pigatron-industries/xen_matrix/README.md

# Matrix Mixer

A Eurorack module 6x6 matrix mixer
