pigatron-industries/xen_matrix/hardware/xen_matrix_controls_6x6.pdf

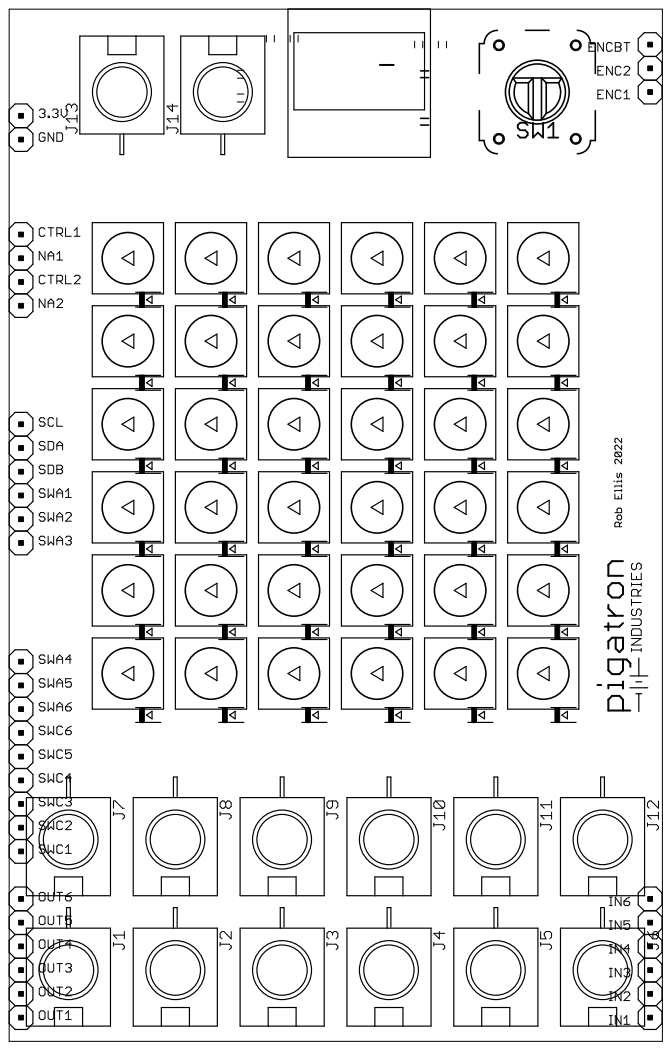
[picture p1: page 1]
