pigatron-industries/xen_matrix/hardware/xen_matrix_panel.pdf

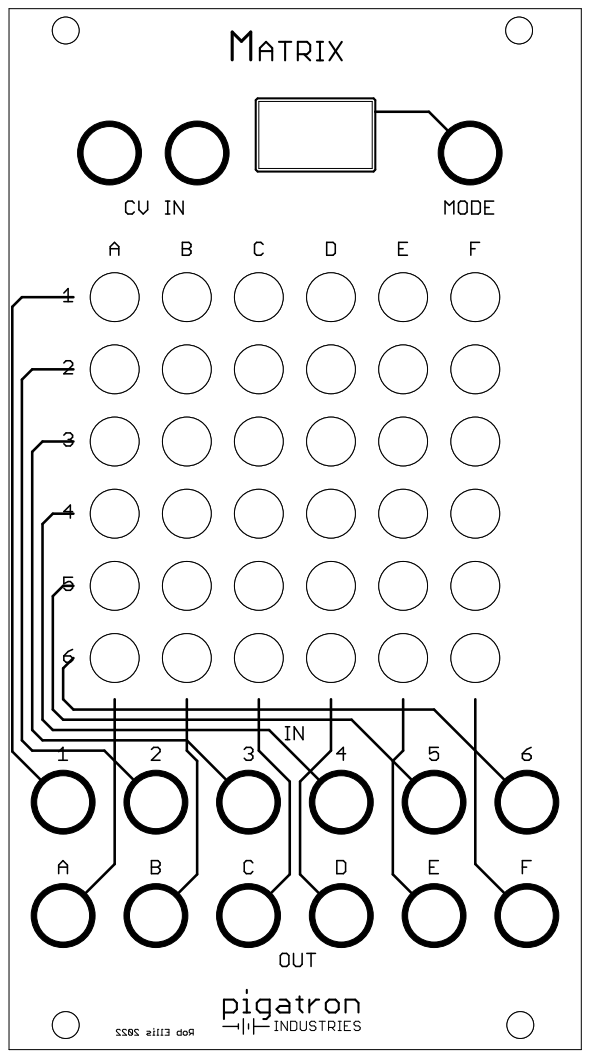
[picture p2: page 1]
