pigatron-industries/xen_matrix/hardware/xen_teensy_motherboard_matrix_mki.pdf

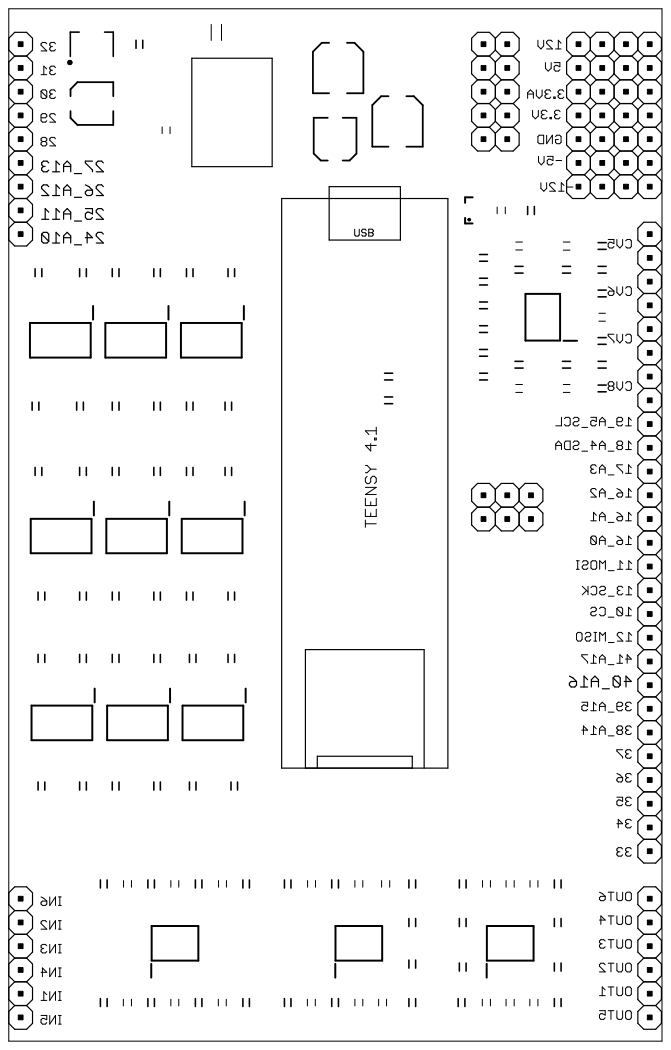
[picture p3: page 1]
