pigatron-industries/xen_matrix/hardware/xen_teensy_motherboard_matrix_mki.brd

## EAGLE design hardware/xen_teensy_motherboard_matrix_mki.brd (2023-10-28)

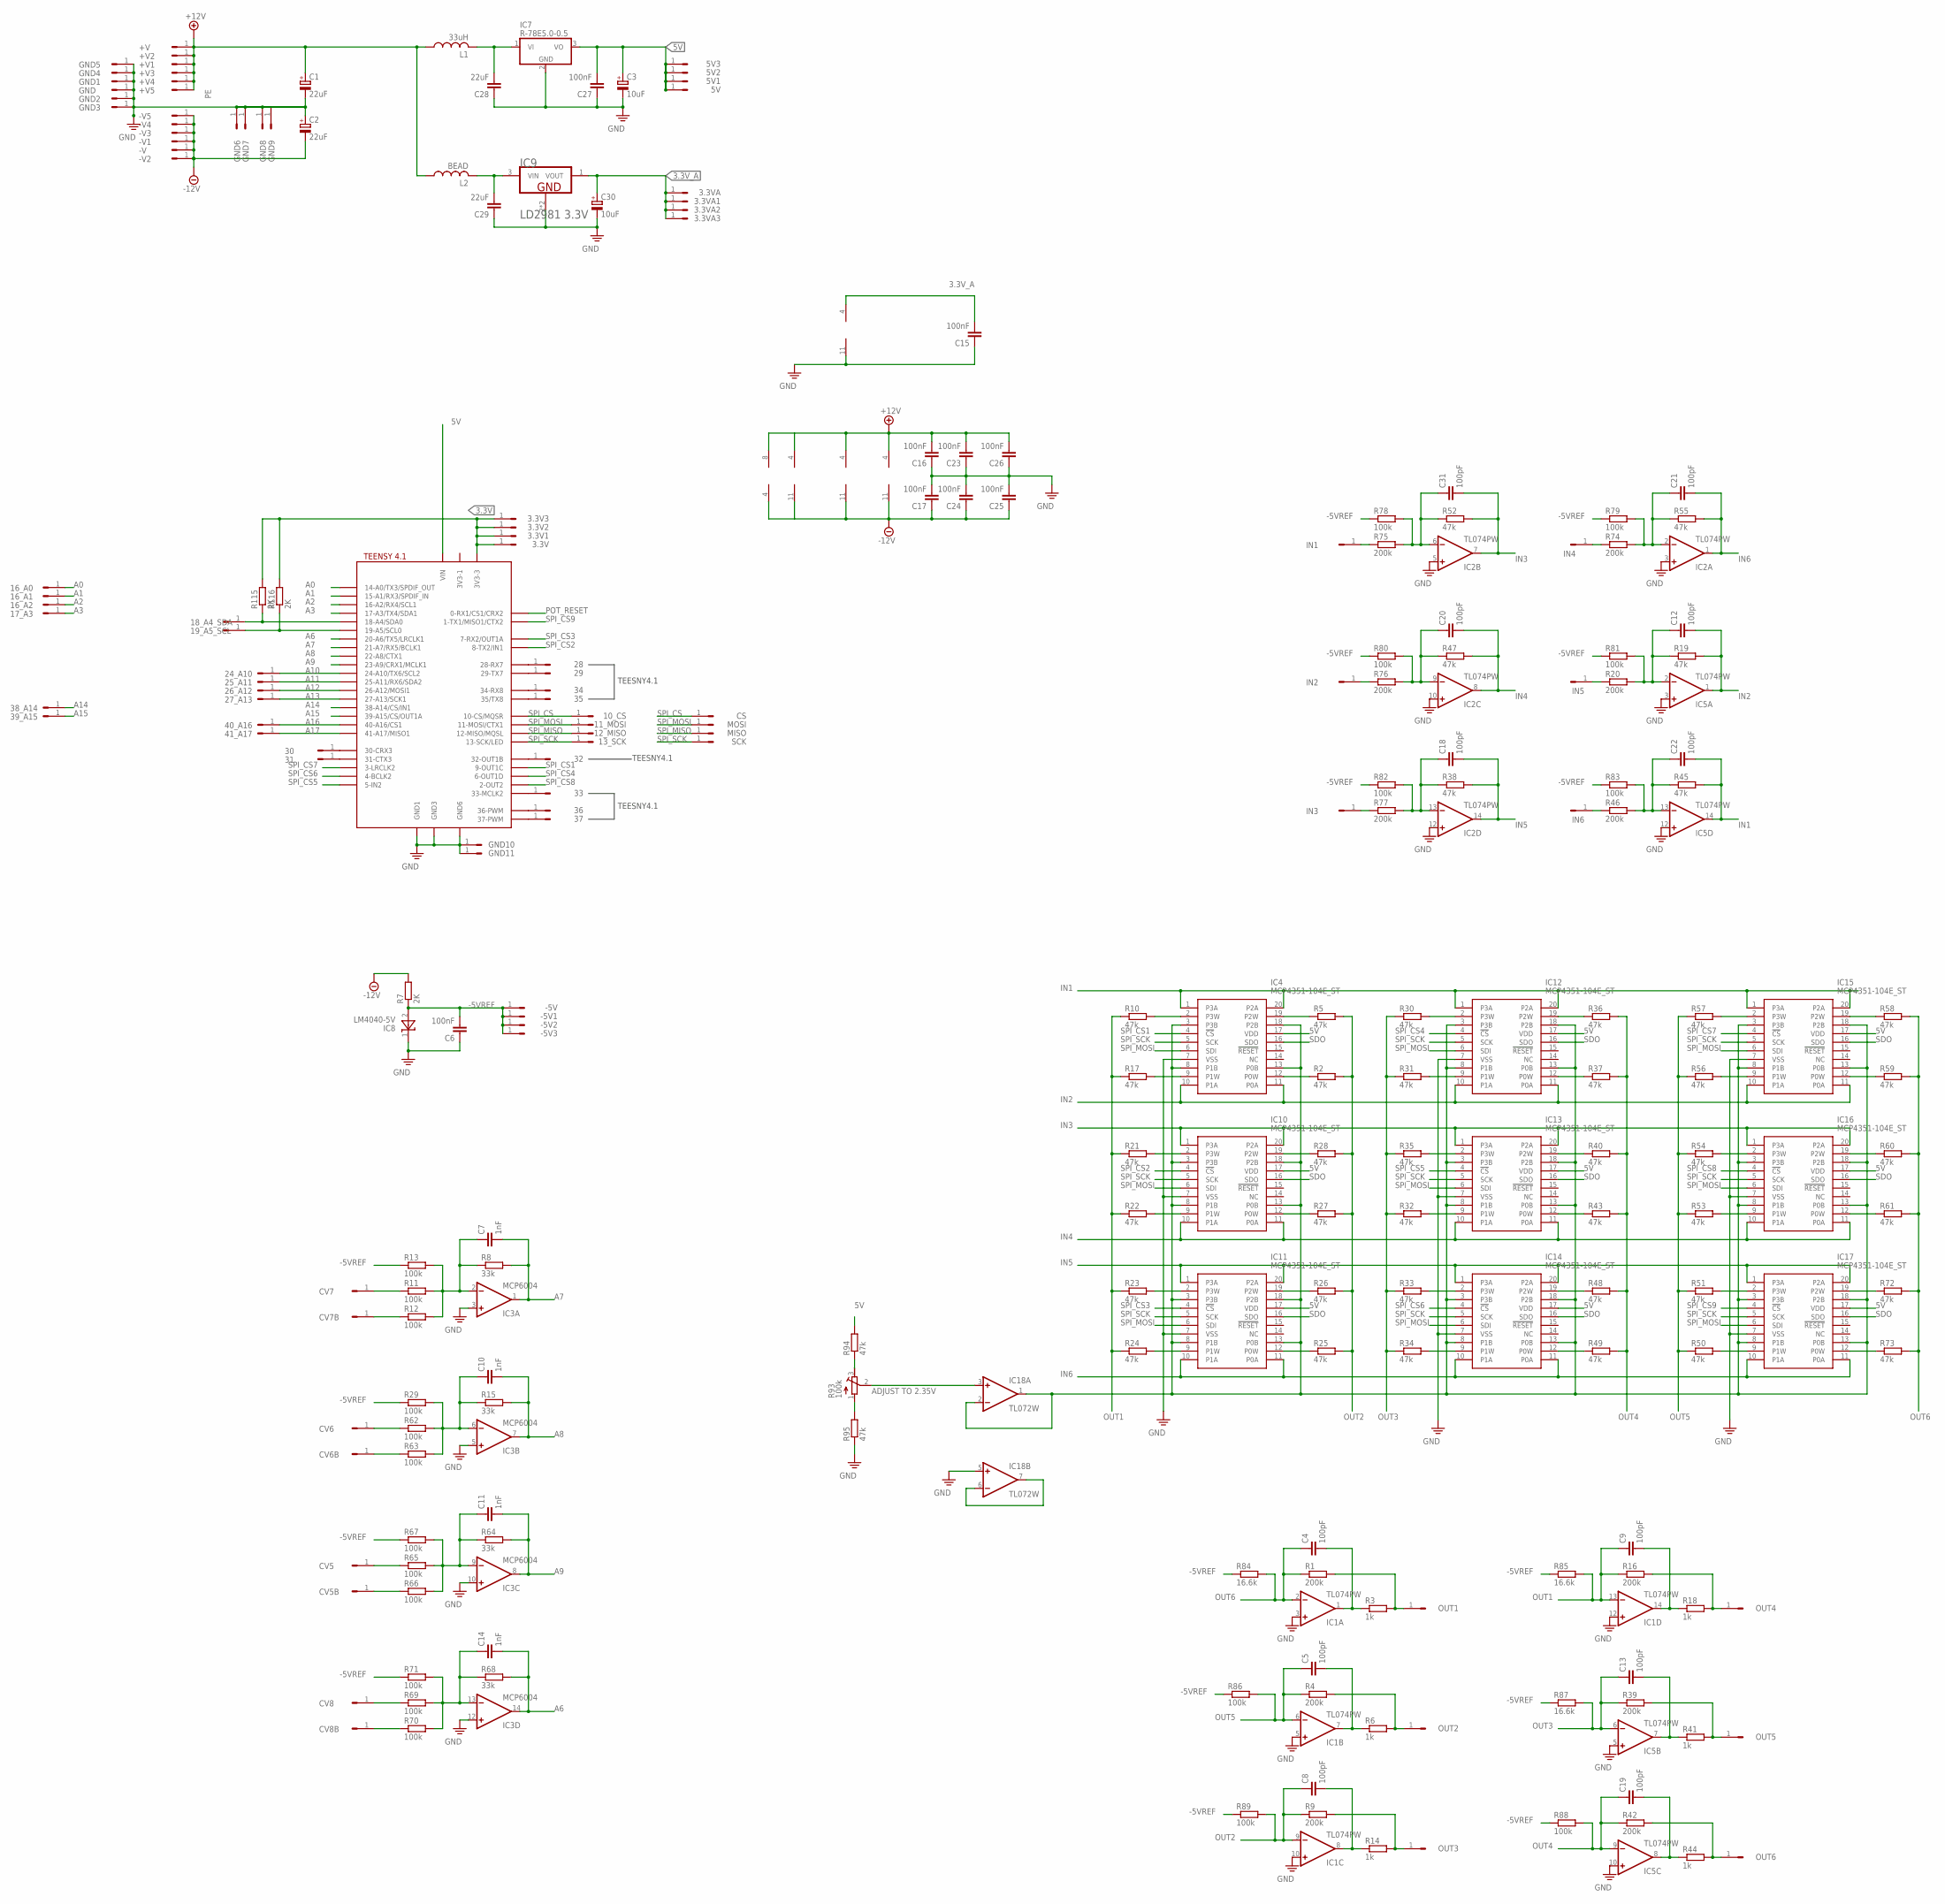
[picture p4: schematic xen_teensy_motherboard_matrix_mki.sch]

Parts:
3.3V, 3.3V1, 3.3V2, 3.3V3, 3.3VA, 3.3VA1, 3.3VA2, 3.3VA3, 5V, 5V1, 5V2, 5V3, 10_CS, 11_MOSI, 12_MISO, 13_SCK, 16_A0, 16_A1, 16_A2, 17_A3, 18_A4_SDA, 19_A5_SCL, 24_A10, 25_A11, 26_A12, 27_A13, 28, 29, 30, 31, 32, 33, 34, 35, 36, 37, 38_A14, 39_A15, 40_A16, 41_A17: HEADER/MALE/01
+V, +V1, +V2, +V3, +V4, +V5: HEADER/MALE/01
-5V, -5V1, -5V2, -5V3: HEADER/MALE/01
-V, -V1, -V2, -V3, -V4, -V5: HEADER/MALE/01
C1, C2: 22uF; SV-C
C3, C30: 10uF; SV-B
C4, C5, C8, C9, C12, C13, C18, C19, C20, C21, C22, C31: 100pF; C0603
C6, C15, C16, C17, C23, C24, C25, C26, C27: 100nF; C0603
C7, C10, C11, C14: 1nF; C0603
C28, C29: 22uF; C0805
CS: HEADER/MALE/01
CV5, CV5B, CV6, CV6B, CV7, CV7B, CV8, CV8B: HEADER/MALE/01
GND, GND1, GND2, GND3, GND4, GND5, GND6, GND7, GND8, GND9, GND10, GND11: HEADER/MALE/01
IC1, IC2, IC5: TL074PW; TSSOP14
IC3: MCP6004; TSSOP14
IC4, IC10, IC11, IC12, IC13, IC14, IC15, IC16, IC17: MCP4351-104E_ST; SOP65P640X120-20N
IC6: TEENSY41-OUTER; TENNSY41-OUTER
IC7: R-78E5.0-0.5; WE78
IC8: LM4040-5V; SOT-23
IC9: LD2981 3.3V; LD2981-SOT89
IC18: TL072W; TSSOP08
IN1, IN2, IN3, IN4, IN5, IN6: HEADER/MALE/01
L1: 33uH; L2012C
L2: BEAD; R0603
MISO: HEADER/MALE/01
MOSI: HEADER/MALE/01
OUT1, OUT2, OUT3, OUT4, OUT5, OUT6: HEADER/MALE/01
R1, R4, R9, R16, R20, R39, R42, R46, R74, R75, R76, R77: 200k; R0603
R2, R5, R10, R17, R19, R21, R22, R23, R24, R25, R26, R27, R28, R30, R31, R32, R33, R34, R35, R36, R37, R38, R40, R43, R45, R47, R48, R49, R50, R51, R52, R53, R54, R55, R56, R57, R58, R59, R60, R61, R72, R73, R94, R95: 47k; R0603
R3, R6, R14, R18, R41, R44: 1k; R0603
R7, R115, R116: 2K; R0603
R8, R15, R64, R68: 33k; R0603
R11, R12, R13, R29, R62, R63, R65, R66, R67, R69, R70, R71, R78, R79, R80, R81, R82, R83, R86, R88, R89: 100k; R0603
R84, R85, R87: 16.6k; R0603
R93: 100k; TRIMMER/64B
SCK: HEADER/MALE/01

Connections:
3.3V: 3.3V.1, 3.3V1.1, 3.3V2.1, 3.3V3.1, IC6.3V3-3, R115.2, R116.2
3.3V_A: 3.3VA.1, 3.3VA1.1, 3.3VA2.1, 3.3VA3.1, C15.2, C30.+, IC3.4 (V+), IC9.1 (VOUT)
5V: 5V.1, 5V1.1, 5V2.1, 5V3.1, C3.+, C27.2, IC4.17 (VDD), IC6.VIN, IC7.3 (VO), IC10.17 (VDD), IC11.17 (VDD), IC12.17 (VDD), IC13.17 (VDD), IC14.17 (VDD), IC15.17 (VDD), IC16.17 (VDD), IC17.17 (VDD), R94.2
+12V: +V.1, +V1.1, +V2.1, +V3.1, +V4.1, +V5.1, C1.+, C16.2, C23.2, C26.2, IC1.4 (V+), IC2.4 (V+), IC5.4 (V+), IC18.8 (V+), L1.1, L2.1
-5VREF: -5V.1, -5V1.1, -5V2.1, -5V3.1, C6.2, IC8.2 (A), R7.1, R13.1, R29.1, R67.1, R71.1, R78.1, R79.1, R80.1, R81.1, R82.1, R83.1, R84.1, R85.1, R86.1, R87.1, R88.1, R89.1
-12V: -V.1, -V1.1, -V2.1, -V3.1, -V4.1, -V5.1, C2.-, C17.1, C24.1, C25.1, IC1.11 (V-), IC2.11 (V-), IC5.11 (V-), IC18.4 (V-), R7.2
A0: 16_A0.1, IC6.14-A0/TX3/SPDIF_OUT
A1: 16_A1.1, IC6.15-A1/RX3/SPDIF_IN
A2: 16_A2.1, IC6.16-A2/RX4/SCL1
A3: 17_A3.1, IC6.17-A3/TX4/SDA1
A5: 19_A5_SCL.1, IC6.19-A5/SCL0, R116.1
A6: C14.2, IC3.14 (OUT), IC6.20-A6/TX5/LRCLK1, R68.2
A7: C7.2, IC3.1 (OUT), IC6.21-A7/RX5/BCLK1, R8.2
A8: C10.2, IC3.7 (OUT), IC6.22-A8/CTX1, R15.2
A9: C11.2, IC3.8 (OUT), IC6.23-A9/CRX1/MCLK1, R64.2
A10: 24_A10.1, IC6.24-A10/TX6/SCL2
A11: 25_A11.1, IC6.25-A11/RX6/SDA2
A12: 26_A12.1, IC6.26-A12/MOSI1
A13: 27_A13.1, IC6.27-A13/SCK1
A14: 38_A14.1, IC6.38-A14/CS/IN1
A15: 39_A15.1, IC6.39-A15/CS/OUT1A
A16: 40_A16.1, IC6.40-A16/CS1
A17: 41_A17.1, IC6.41-A17/MISO1
DAC1: IN6.1, R46.1
DAC2: IN5.1, R20.1
IN1: C22.2, IC4.1 (P3A), IC4.20 (P2A), IC5.14 (OUT), IC12.1 (P3A), IC12.20 (P2A), IC15.1 (P3A), IC15.20 (P2A), R45.2
IN2: C12.2, IC4.10 (P1A), IC4.11 (P0A), IC5.1 (OUT), IC12.10 (P1A), IC12.11 (P0A), IC15.10 (P1A), IC15.11 (P0A), R19.2
IN3: C31.2, IC2.7 (OUT), IC10.1 (P3A), IC10.20 (P2A), IC13.1 (P3A), IC13.20 (P2A), IC16.1 (P3A), IC16.20 (P2A), R52.2
IN4: C20.2, IC2.8 (OUT), IC10.10 (P1A), IC10.11 (P0A), IC13.10 (P1A), IC13.11 (P0A), IC16.10 (P1A), IC16.11 (P0A), R47.2
IN5: C18.2, IC2.14 (OUT), IC11.1 (P3A), IC11.20 (P2A), IC14.1 (P3A), IC14.20 (P2A), IC17.1 (P3A), IC17.20 (P2A), R38.2
IN6: C21.2, IC2.1 (OUT), IC11.10 (P1A), IC11.11 (P0A), IC14.10 (P1A), IC14.11 (P0A), IC17.10 (P1A), IC17.11 (P0A), R55.2
unnamed: IC4.2 (P3W), R10.2
unnamed: C18.1, IC2.13 (-IN), R38.1, R77.2, R82.2
unnamed: C4.2, IC1.1 (OUT), R3.1
unnamed: OUT1.1, R1.2, R3.2
unnamed: IC4.3 (P3B), IC4.8 (P1B), IC4.13 (P0B), IC4.18 (P2B), IC10.3 (P3B), IC10.8 (P1B), IC10.13 (P0B), IC10.18 (P2B), IC11.3 (P3B), IC11.8 (P1B), IC11.13 (P0B), IC11.18 (P2B), IC12.3 (P3B), IC12.8 (P1B), IC12.13 (P0B), IC12.18 (P2B), IC13.3 (P3B), IC13.8 (P1B), IC13.13 (P0B), IC13.18 (P2B), IC14.3 (P3B), IC14.8 (P1B), IC14.13 (P0B), IC14.18 (P2B), IC15.3 (P3B), IC15.8 (P1B), IC15.13 (P0B), IC15.18 (P2B), IC16.3 (P3B), IC16.8 (P1B), IC16.13 (P0B), IC16.18 (P2B), IC17.3 (P3B), IC17.8 (P1B), IC17.13 (P0B), IC17.18 (P2B), IC18.1 (OUT), IC18.2 (-IN)
unnamed: C5.2, IC1.7 (OUT), R6.1
unnamed: OUT2.1, R4.2, R6.2
unnamed: C7.1, IC3.2 (-IN), R8.1, R11.2, R12.2, R13.2
unnamed: IC18.3 (+IN), R93.2 (S)
unnamed: C8.2, IC1.8 (OUT), R14.1
unnamed: OUT3.1, R9.2, R14.2
unnamed: C20.1, IC2.9 (-IN), R47.1, R76.2, R80.2
unnamed: CV7B.1, R12.1
unnamed: CV7.1, R11.1
unnamed: C9.2, IC1.14 (OUT), R18.1
unnamed: C10.1, IC3.6 (-IN), R15.1, R29.2, R62.2, R63.2
unnamed: OUT4.1, R16.2, R18.2
unnamed: CV6.1, R62.1
unnamed: CV6B.1, R63.1
unnamed: C12.1, IC5.2 (-IN), R19.1, R20.2, R81.2
unnamed: IC18.6 (-IN), IC18.7 (OUT)
unnamed: IC4.9 (P1W), R17.2
unnamed: IC10.2 (P3W), R21.2
unnamed: IC10.9 (P1W), R22.2
unnamed: IC11.2 (P3W), R23.2
unnamed: IC11.9 (P1W), R24.2
unnamed: C31.1, IC2.6 (-IN), R52.1, R75.2, R78.2
unnamed: IC11.12 (P0W), R25.1
unnamed: IC11.19 (P2W), R26.1
unnamed: IC10.12 (P0W), R27.1
unnamed: IC10.19 (P2W), R28.1
unnamed: C13.2, IC5.7 (OUT), R41.1
unnamed: IC4.12 (P0W), R2.1
unnamed: IC4.19 (P2W), R5.1
unnamed: IC12.2 (P3W), R30.2
unnamed: IC12.9 (P1W), R31.2
unnamed: IC13.2 (P3W), R35.2
unnamed: IC13.9 (P1W), R32.2
unnamed: IC14.2 (P3W), R33.2
unnamed: IC14.9 (P1W), R34.2
unnamed: OUT5.1, R39.2, R41.2
unnamed: R93.1 (E), R95.2
unnamed: C19.2, IC5.8 (OUT), R44.1
unnamed: 18_A4_SDA.1, IC6.18-A4/SDA0, R115.1
unnamed: IC14.12 (P0W), R49.1
unnamed: OUT6.1, R42.2, R44.2
unnamed: C22.1, IC5.13 (-IN), R45.1, R46.2, R83.2
unnamed: R93.3 (A), R94.1
unnamed: C21.1, IC2.2 (-IN), R55.1, R74.2, R79.2
unnamed: C28.2, IC7.1 (VI), L1.2
unnamed: IC14.19 (P2W), R48.1
unnamed: IC13.12 (P0W), R43.1
unnamed: IC13.19 (P2W), R40.1
unnamed: IC12.12 (P0W), R37.1
unnamed: IC12.19 (P2W), R36.1
unnamed: C14.1, IC3.13 (-IN), R68.1, R69.2, R70.2, R71.2
unnamed: IC15.2 (P3W), R57.2
unnamed: IC15.9 (P1W), R56.2
unnamed: CV8.1, R69.1
unnamed: IC16.2 (P3W), R54.2
unnamed: IC16.9 (P1W), R53.2
unnamed: IC17.2 (P3W), R51.2
unnamed: IC17.9 (P1W), R50.2
unnamed: IC17.12 (P0W), R73.1
unnamed: IC17.19 (P2W), R72.1
unnamed: IC16.12 (P0W), R61.1
unnamed: CV8B.1, R70.1
unnamed: CV5B.1, R66.1
unnamed: CV5.1, R65.1
unnamed: C11.1, IC3.9 (-IN), R64.1, R65.2, R66.2, R67.2
unnamed: C29.2, IC9.3 (VIN), L2.2
unnamed: IC16.19 (P2W), R60.1
unnamed: IC15.12 (P0W), R59.1
unnamed: IC15.19 (P2W), R58.1
unnamed: IN1.1, R75.1
unnamed: IN2.1, R76.1
unnamed: IN3.1, R77.1
unnamed: IN4.1, R74.1
unnamed: 28.1, IC6.28-RX7
unnamed: 29.1, IC6.29-TX7
unnamed: 30.1, IC6.30-CRX3
unnamed: 31.1, IC6.31-CTX3
unnamed: 32.1, IC6.32-OUT1B
unnamed: 34.1, IC6.34-RX8
unnamed: 35.1, IC6.35-TX8 (35/TX8)
unnamed: 33.1, IC6.33-MCLK2
unnamed: 36.1, IC6.36-PWM
unnamed: 37.1, IC6.37-PWM
OUT1: C9.1, IC1.13 (-IN), R10.1, R16.1, R17.1, R21.1, R22.1, R23.1, R24.1, R85.2
OUT2: C8.1, IC1.9 (-IN), R2.2, R5.2, R9.1, R25.2, R26.2, R27.2, R28.2, R89.2
OUT3: C13.1, IC5.6 (-IN), R30.1, R31.1, R32.1, R33.1, R34.1, R35.1, R39.1, R87.2
OUT4: C19.1, IC5.9 (-IN), R36.2, R37.2, R40.2, R42.1, R43.2, R48.2, R49.2, R88.2
OUT5: C5.1, IC1.6 (-IN), R4.1, R50.1, R51.1, R53.1, R54.1, R56.1, R57.1, R86.2
OUT6: C4.1, IC1.2 (-IN), R1.1, R58.2, R59.2, R60.2, R61.2, R72.2, R73.2, R84.2
PE: C1.-, C2.+, C3.-, C6.1, C15.1, C16.1, C17.2, C23.1, C24.2, C25.2, C26.1, C27.1, C28.1, C29.1, C30.-, GND.1, GND1.1, GND2.1, GND3.1, GND4.1, GND5.1, GND6.1, GND7.1, GND8.1, GND9.1, GND10.1, GND11.1, IC1.3 (+IN), IC1.5 (+IN), IC1.10 (+IN), IC1.12 (+IN), IC2.3 (+IN), IC2.5 (+IN), IC2.10 (+IN), IC2.12 (+IN), IC3.3 (+IN), IC3.5 (+IN), IC3.10 (+IN), IC3.11 (V-), IC3.12 (+IN), IC4.7 (VSS), IC5.3 (+IN), IC5.5 (+IN), IC5.10 (+IN), IC5.12 (+IN), IC6.GND1, IC6.GND3, IC6.GND6, IC7.2 (GND), IC8.1 (C), IC9.2 (GND), IC9.2-2 (GND), IC10.7 (VSS), IC11.7 (VSS), IC12.7 (VSS), IC13.7 (VSS), IC14.7 (VSS), IC15.7 (VSS), IC16.7 (VSS), IC17.7 (VSS), IC18.5 (+IN), R95.1
POT_RESET: IC6.0-RX1/CS1/CRX2
SDO: IC4.16 (SDO), IC10.16 (SDO), IC11.16 (SDO), IC12.16 (SDO), IC13.16 (SDO), IC14.16 (SDO), IC15.16 (SDO), IC16.16 (SDO), IC17.16 (SDO)
SPI_CS: 10_CS.1, CS.1, IC6.10-CS\MQSR (10-CS/MQSR)
SPI_CS1: IC4.4 (!CS), IC6.9-OUT1C
SPI_CS2: IC6.8-TX2/IN1, IC10.4 (!CS)
SPI_CS3: IC6.7-RX2/OUT1A, IC11.4 (!CS)
SPI_CS4: IC6.6-OUT1D, IC12.4 (!CS)
SPI_CS5: IC6.5-IN2, IC13.4 (!CS)
SPI_CS6: IC6.4-BCLK2, IC14.4 (!CS)
SPI_CS7: IC6.3-LRCLK2, IC15.4 (!CS)
SPI_CS8: IC6.2-OUT2, IC16.4 (!CS)
SPI_CS9: IC6.1-TX1/MISO1/CTX2, IC17.4 (!CS)
SPI_MISO: 12_MISO.1, IC6.12-MISO/MQSL, MISO.1
SPI_MOSI: 11_MOSI.1, IC4.6 (SDI), IC6.11-MOSI/CTX1, IC10.6 (SDI), IC11.6 (SDI), IC12.6 (SDI), IC13.6 (SDI), IC14.6 (SDI), IC15.6 (SDI), IC16.6 (SDI), IC17.6 (SDI), MOSI.1
SPI_SCK: 13_SCK.1, IC4.5 (SCK), IC6.13-SCK/LED, IC10.5 (SCK), IC11.5 (SCK), IC12.5 (SCK), IC13.5 (SCK), IC14.5 (SCK), IC15.5 (SCK), IC16.5 (SCK), IC17.5 (SCK), SCK.1

Notes on the sheet:
TEESNY4.1
ADJUST TO 2.35V

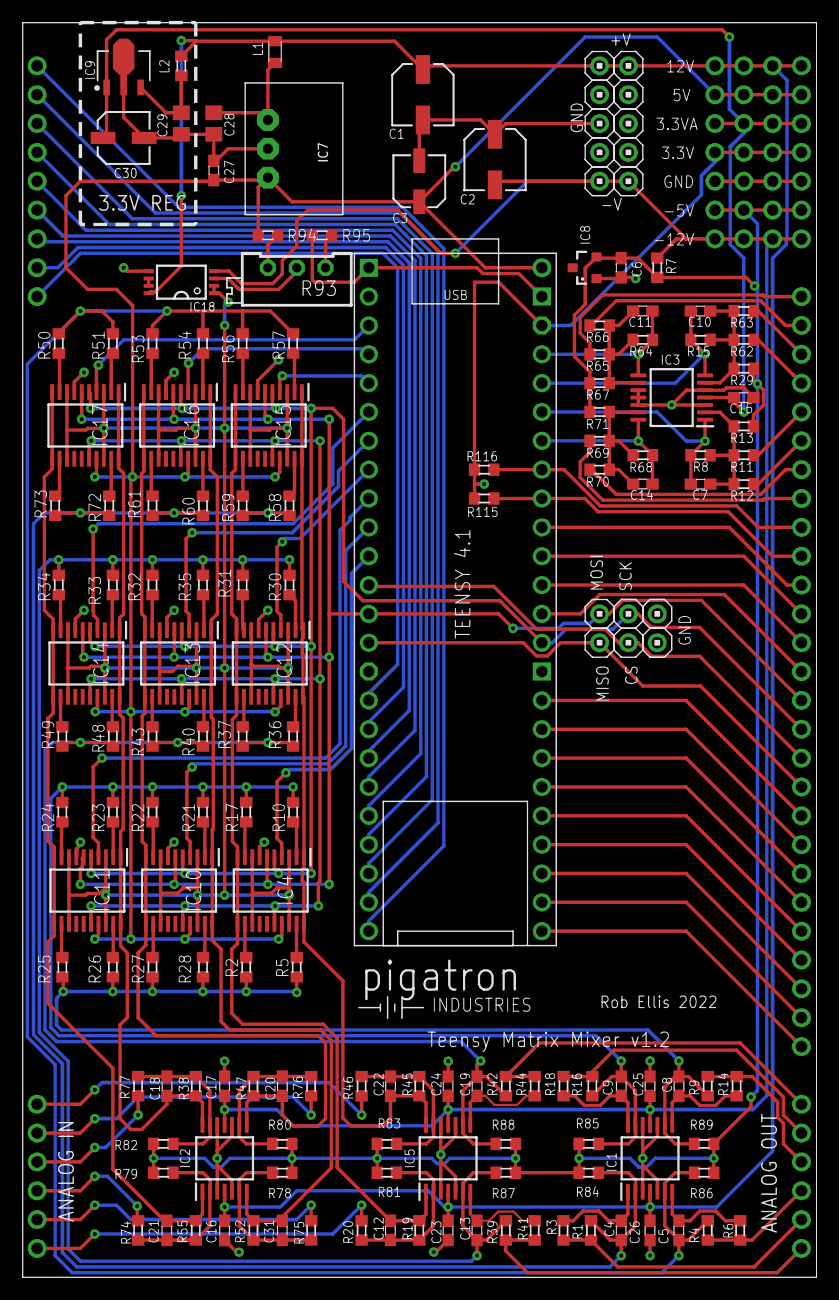
[picture p5: board xen_teensy_motherboard_matrix_mki.brd from above]

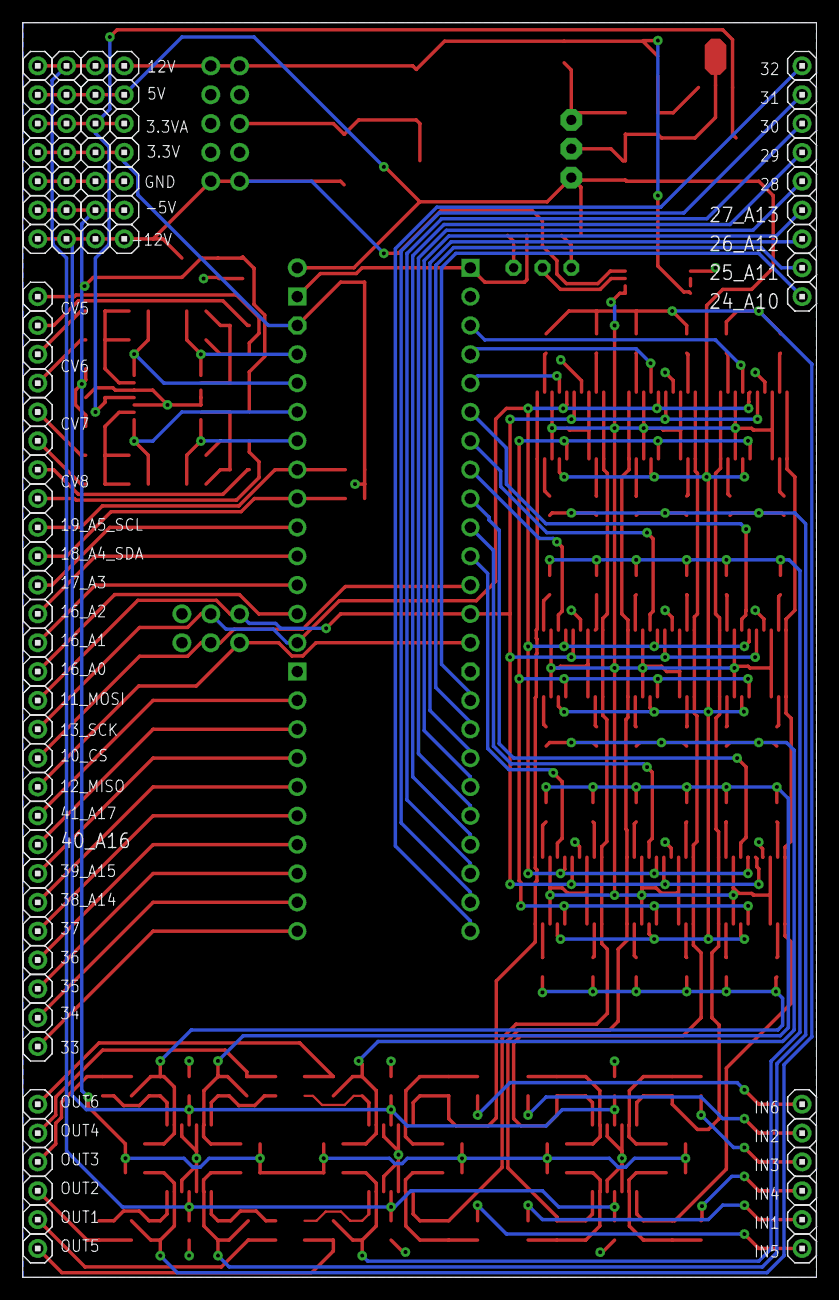
[picture p6: board xen_teensy_motherboard_matrix_mki.brd from below]

Board: 2 copper layers, 69.9 x 110.5 mm, 238 parts (76 on the bottom side), 140 nets.

Other parts of the board:
U$1: PIGATRON-LOGO
