pigatron-industries/xen_matrix/hardware/xen_matrix_controls_6x6.brd

## EAGLE design hardware/xen_matrix_controls_6x6.brd (2023-02-06)

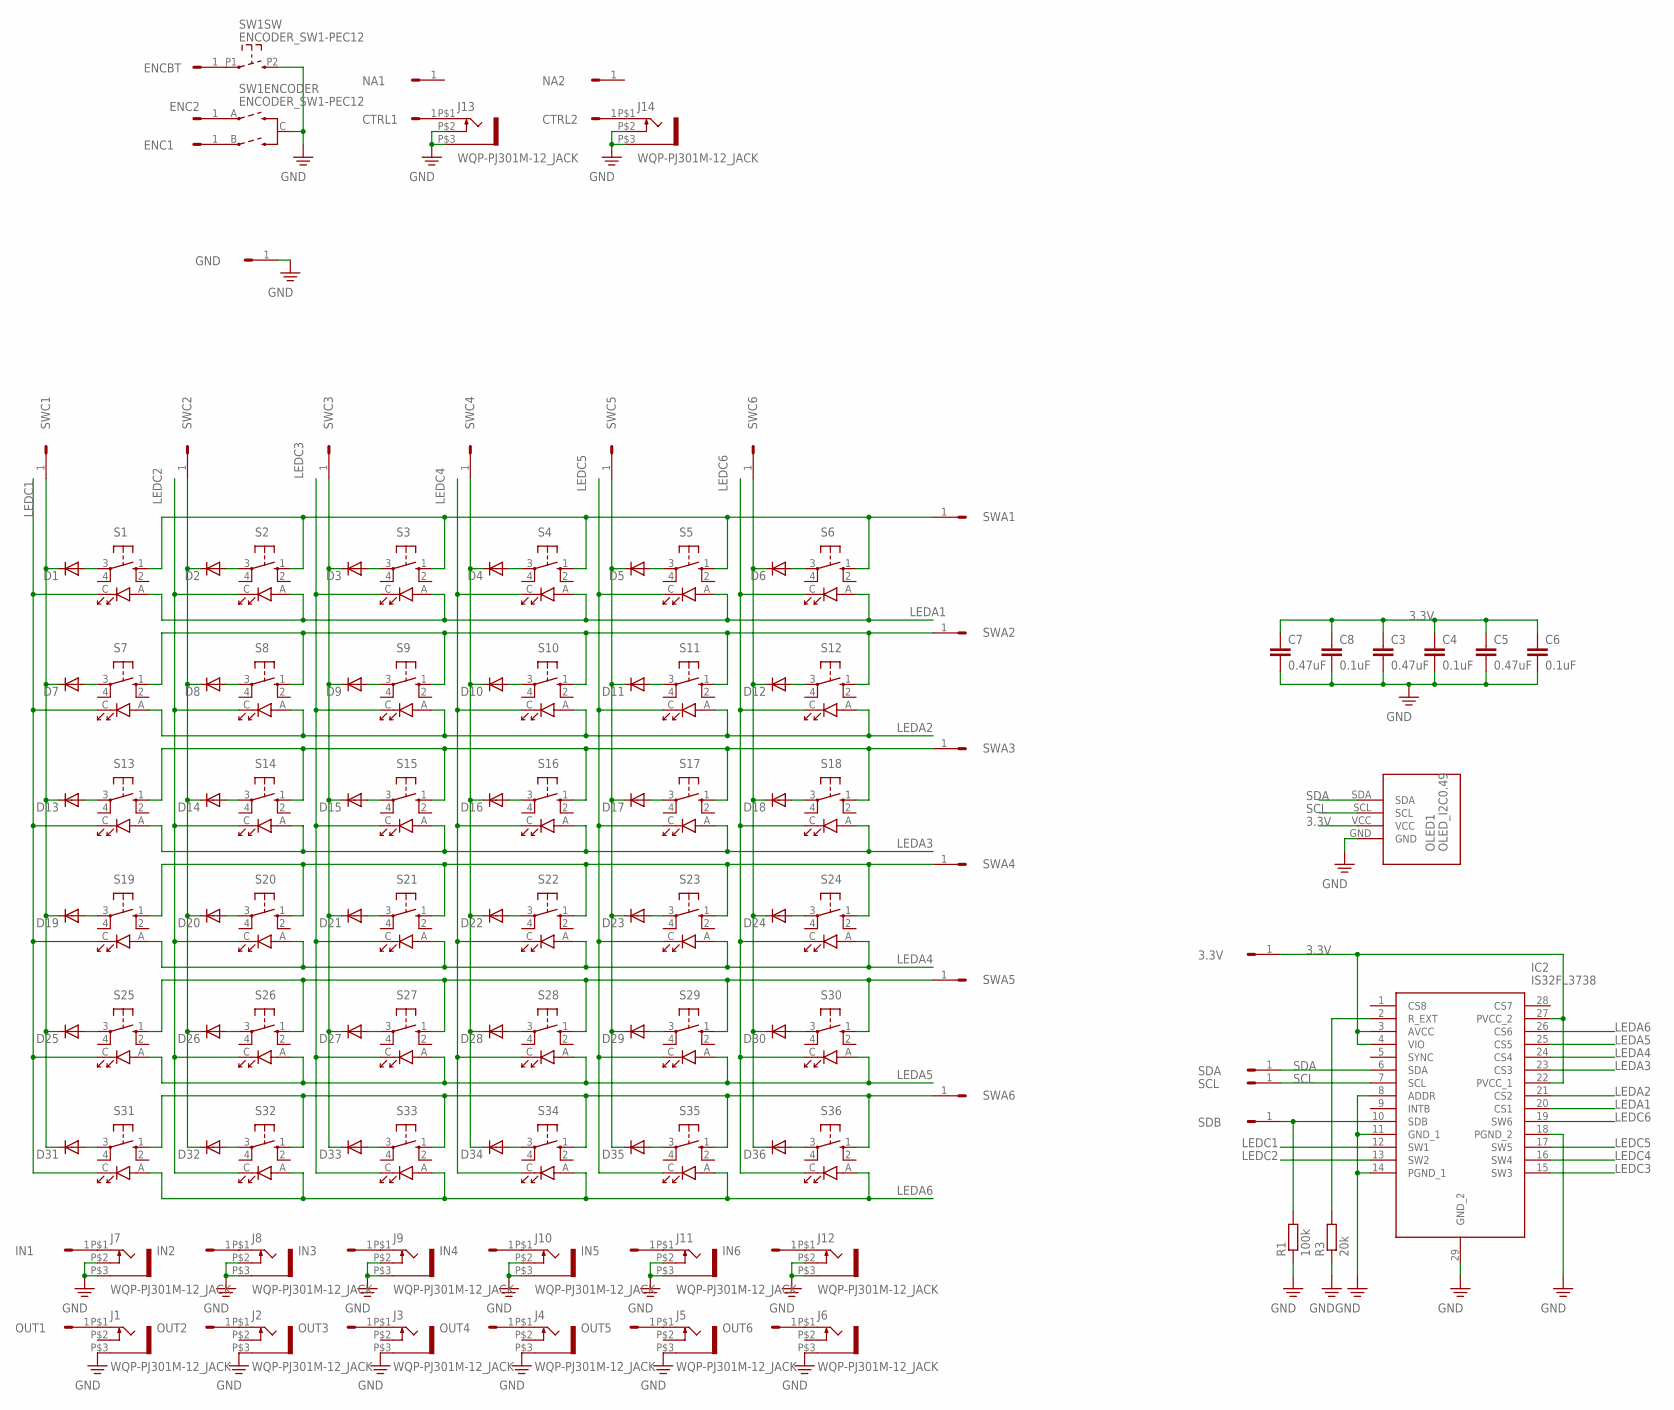
[picture p7: schematic xen_matrix_controls_6x6.sch]

Parts:
3.3V: HEADER/MALE/01
C3, C5, C7: 0.47uF; C0603
C4, C6, C8: 0.1uF; C0603
CTRL1, CTRL2: HEADER/MALE/01
D1, D2, D3, D4, D5, D6, D7, D8, D9, D10, D11, D12, D13, D14, D15, D16, D17, D18, D19, D20, D21, D22, D23, D24, D25, D26, D27, D28, D29, D30, D31, D32, D33, D34, D35, D36: 1N4148SOD-123; SOD-123
ENC1, ENC2: HEADER/MALE/01
ENCBT: HEADER/MALE/01
GND: HEADER/MALE/01
IC2: IS32FL3738; TSSOP29
IN1, IN2, IN3, IN4, IN5, IN6: HEADER/MALE/01
J1, J2, J3, J4, J5, J6, J7, J8, J9, J10, J11, J12, J13, J14: WQP-PJ301M-12_JACK
NA1, NA2: HEADER/MALE/01
OLED1: OLED_I2C0.49; OLEDM0.49
OUT1, OUT2, OUT3, OUT4, OUT5, OUT6: HEADER/MALE/01
R1: 100k; R0603
R3: 20k; R0603
S1, S2, S3, S4, S5, S6, S7, S8, S9, S10, S11, S12, S13, S14, S15, S16, S17, S18, S19, S20, S21, S22, S23, S24, S25, S26, S27, S28, S29, S30, S31, S32, S33, S34, S35, S36: SW-LEDTHONK; SW-PUSH-TACT-LED-THONK
SCL: HEADER/MALE/01
SDA: HEADER/MALE/01
SDB: HEADER/MALE/01
SW1: ENCODER_SW1-PEC12; PEC12_INCREMENTAL_ENCODER
SWA1, SWA2, SWA3, SWA4, SWA5, SWA6: HEADER/MALE/01
SWC1, SWC2, SWC3, SWC4, SWC5, SWC6: HEADER/MALE/01

Connections:
3.3V: 3.3V.1, C3.1, C4.1, C5.1, C6.1, C7.1, C8.1, IC2.3 (AVCC), IC2.4 (VIO), IC2.22 (PVCC_1), IC2.27 (PVCC_2), OLED1.VCC
LEDA1: IC2.20 (CS1), S1.A, S2.A, S3.A, S4.A, S5.A, S6.A
LEDA2: IC2.21 (CS2), S7.A, S8.A, S9.A, S10.A, S11.A, S12.A
LEDA3: IC2.23 (CS3), S13.A, S14.A, S15.A, S16.A, S17.A, S18.A
LEDA4: IC2.24 (CS4), S19.A, S20.A, S21.A, S22.A, S23.A, S24.A
LEDA5: IC2.25 (CS5), S25.A, S26.A, S27.A, S28.A, S29.A, S30.A
LEDA6: IC2.26 (CS6), S31.A, S32.A, S33.A, S34.A, S35.A, S36.A
LEDC1: IC2.12 (SW1), S1.C, S7.C, S13.C, S19.C, S25.C, S31.C
LEDC2: IC2.13 (SW2), S2.C, S8.C, S14.C, S20.C, S26.C, S32.C
LEDC3: IC2.15 (SW3), S3.C, S9.C, S15.C, S21.C, S27.C, S33.C
LEDC4: IC2.16 (SW4), S4.C, S10.C, S16.C, S22.C, S28.C, S34.C
LEDC5: IC2.17 (SW5), S5.C, S11.C, S17.C, S23.C, S29.C, S35.C
LEDC6: IC2.19 (SW6), S6.C, S12.C, S18.C, S24.C, S30.C, S36.C
unnamed: IC2.10 (SDB), R1.2, SDB.1
unnamed: IC2.2 (R_EXT), R3.2
unnamed: S25.1 (S), S26.1 (S), S27.1 (S), S28.1 (S), S29.1 (S), S30.1 (S), SWA5.1
unnamed: S1.1 (S), S2.1 (S), S3.1 (S), S4.1 (S), S5.1 (S), S6.1 (S), SWA1.1
unnamed: D1.A, S1.3
unnamed: S7.1 (S), S8.1 (S), S9.1 (S), S10.1 (S), S11.1 (S), S12.1 (S), SWA2.1
unnamed: D4.A, S4.3
unnamed: D5.A, S5.3
unnamed: S13.1 (S), S14.1 (S), S15.1 (S), S16.1 (S), S17.1 (S), S18.1 (S), SWA3.1
unnamed: S19.1 (S), S20.1 (S), S21.1 (S), S22.1 (S), S23.1 (S), S24.1 (S), SWA4.1
unnamed: D6.A, S6.3
unnamed: S31.1 (S), S32.1 (S), S33.1 (S), S34.1 (S), S35.1 (S), S36.1 (S), SWA6.1
unnamed: D7.A, S7.3
unnamed: D8.A, S8.3
unnamed: D9.A, S9.3
unnamed: D10.A, S10.3
unnamed: D11.A, S11.3
unnamed: D12.A, S12.3
unnamed: D13.A, S13.3
unnamed: D14.A, S14.3
unnamed: D15.A, S15.3
unnamed: D16.A, S16.3
unnamed: D17.A, S17.3
unnamed: D18.A, S18.3
unnamed: D19.A, S19.3
unnamed: D20.A, S20.3
unnamed: D21.A, S21.3
unnamed: D22.A, S22.3
unnamed: D23.A, S23.3
unnamed: D24.A, S24.3
unnamed: D25.A, S25.3
unnamed: D26.A, S26.3
unnamed: D27.A, S27.3
unnamed: D28.A, S28.3
unnamed: D29.A, S29.3
unnamed: D30.A, S30.3
unnamed: D31.A, S31.3
unnamed: D32.A, S32.3
unnamed: D33.A, S33.3
unnamed: D34.A, S34.3
unnamed: D35.A, S35.3
unnamed: D36.A, S36.3
unnamed: D2.A, S2.3
unnamed: D3.A, S3.3
unnamed: D1.C, D7.C, D13.C, D19.C, D25.C, D31.C, SWC1.1
unnamed: D2.C, D8.C, D14.C, D20.C, D26.C, D32.C, SWC2.1
unnamed: D3.C, D9.C, D15.C, D21.C, D27.C, D33.C, SWC3.1
unnamed: D4.C, D10.C, D16.C, D22.C, D28.C, D34.C, SWC4.1
unnamed: D5.C, D11.C, D17.C, D23.C, D29.C, D35.C, SWC5.1
unnamed: D6.C, D12.C, D18.C, D24.C, D30.C, D36.C, SWC6.1
unnamed: J2.P$1 (2), OUT2.1
unnamed: J1.P$1 (2), OUT1.1
unnamed: J3.P$1 (2), OUT3.1
unnamed: J4.P$1 (2), OUT4.1
unnamed: J5.P$1 (2), OUT5.1
unnamed: J6.P$1 (2), OUT6.1
unnamed: ENC2.1, SW1.A
unnamed: IN1.1, J7.P$1 (2)
unnamed: IN2.1, J8.P$1 (2)
unnamed: IN3.1, J9.P$1 (2)
unnamed: IN4.1, J10.P$1 (2)
unnamed: IN5.1, J11.P$1 (2)
unnamed: IN6.1, J12.P$1 (2)
unnamed: CTRL1.1, J13.P$1 (2)
unnamed: CTRL2.1, J14.P$1 (2)
unnamed: ENC1.1, SW1.B
unnamed: ENCBT.1, SW1.P1 (1)
PE: C3.2, C4.2, C5.2, C6.2, C7.2, C8.2, GND.1, IC2.8 (ADDR), IC2.11 (GND_1), IC2.14 (PGND_1), IC2.18 (PGND_2), IC2.29 (GND_2), J1.P$3 (1), J2.P$3 (1), J3.P$3 (1), J4.P$3 (1), J5.P$3 (1), J6.P$3 (1), J7.P$2 (3), J7.P$3 (1), J8.P$2 (3), J8.P$3 (1), J9.P$2 (3), J9.P$3 (1), J10.P$2 (3), J10.P$3 (1), J11.P$2 (3), J11.P$3 (1), J12.P$2 (3), J12.P$3 (1), J13.P$2 (3), J13.P$3 (1), J14.P$2 (3), J14.P$3 (1), OLED1.GND, R1.1, R3.1, SW1.C, SW1.P2 (2)
SCL: IC2.7 (SCL), OLED1.SCL, SCL.1
SDA: IC2.6 (SDA), OLED1.SDA, SDA.1

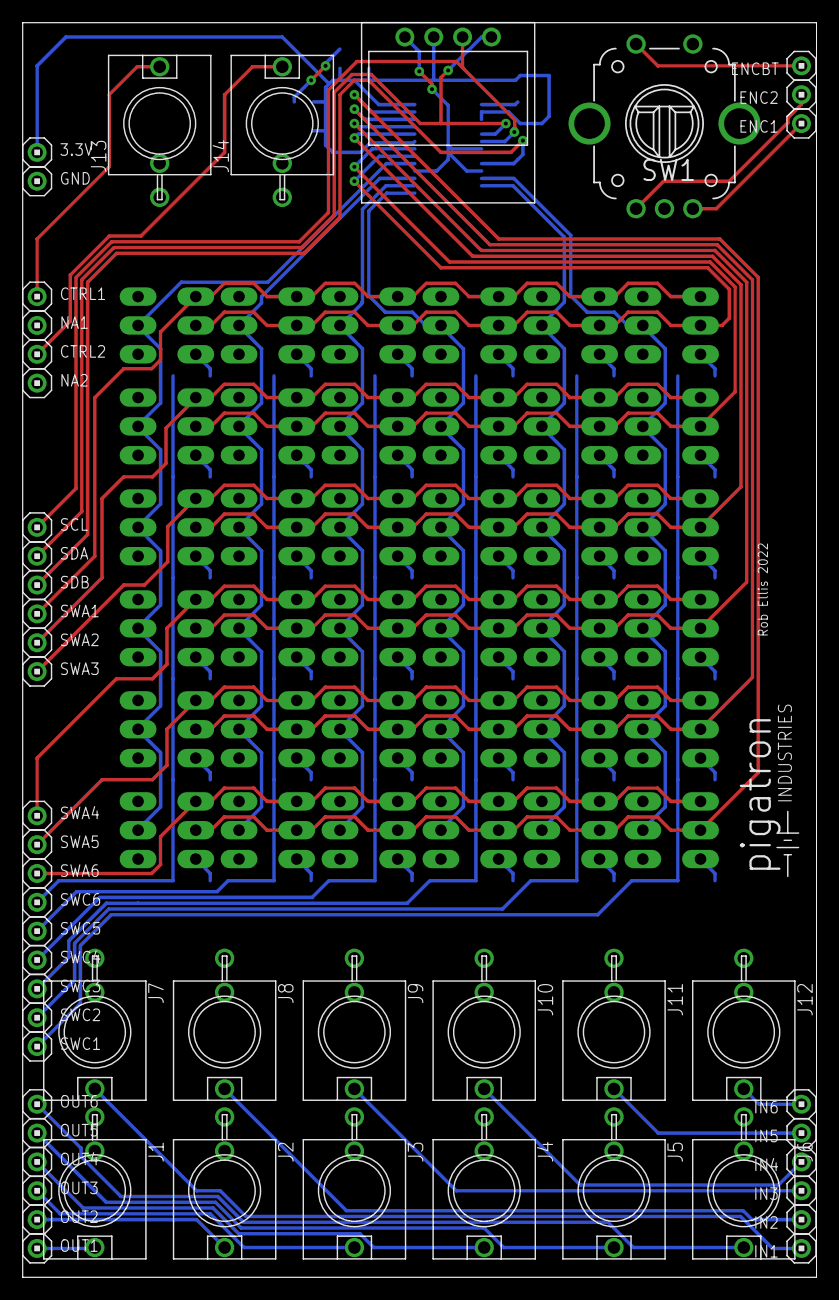
[picture p8: board xen_matrix_controls_6x6.brd from above]

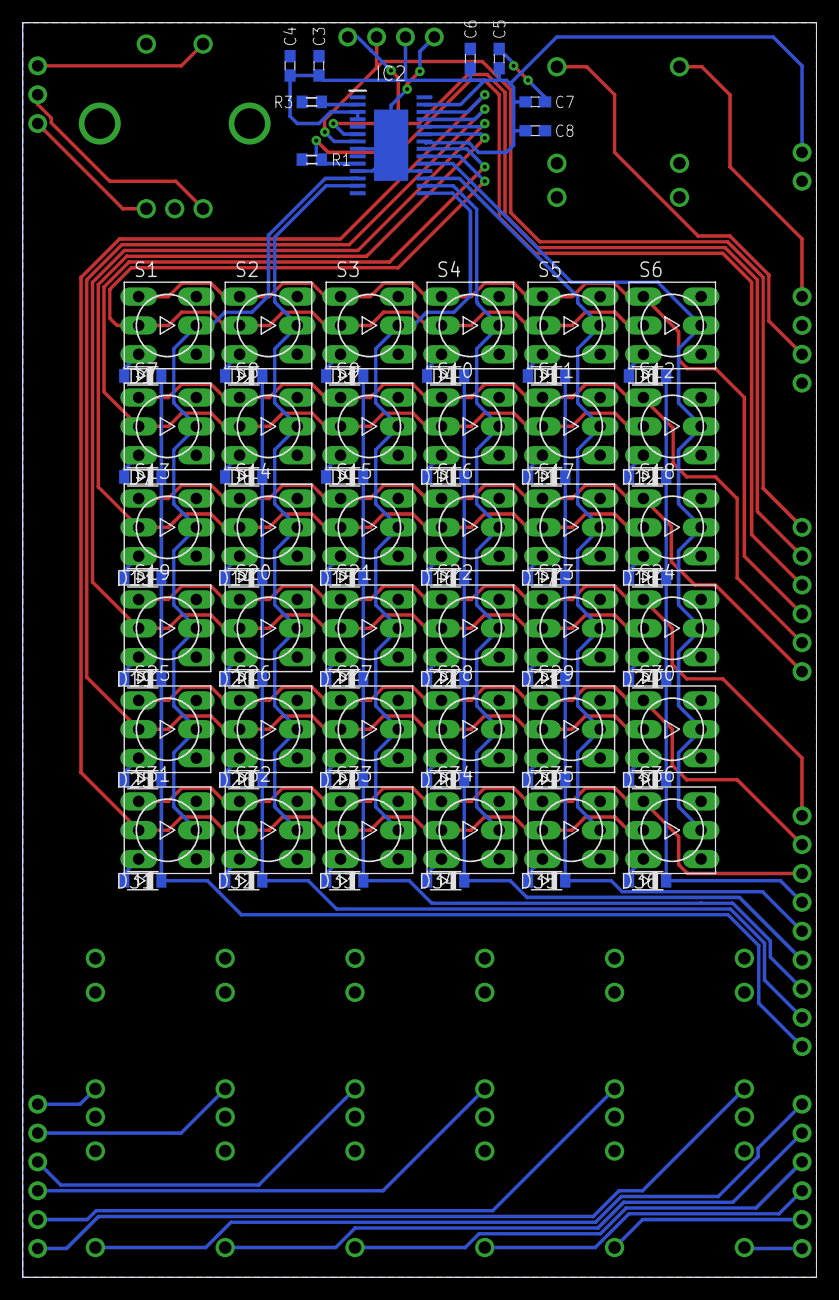
[picture p9: board xen_matrix_controls_6x6.brd from below]

Board: 2 copper layers, 69.9 x 110.5 mm, 134 parts (81 on the bottom side), 83 nets.

Other parts of the board:
U$1: PIGATRON-LOGO
