pigatron-industries/xen_matrix/src/hwconfig.h

// Teensy Pins
#define ENCODER_BTN_PIN 32
#define ENCODER_PIN1 30
#define ENCODER_PIN2 31
#define CV1_PIN A9
#define CV2_PIN A8

#define SDB_PIN 17
#define SCL_PIN 19
#define SDA_PIN 18
#define I2C_SPEED 1000000

#define POT1_CS 9
#define POT2_CS 8
#define POT3_CS 7
#define POT4_CS 6
#define POT5_CS 5
#define POT6_CS 4
#define POT7_CS 3
#define POT8_CS 2
#define POT9_CS 1

#define MATRIX_ROWS 6
#define MATRIX_COLS 6
#define KEY_ROW_PINS {16, 15, 14, 41, 40, 39};
#define KEY_COL_PINS {38, 37, 36, 35, 34, 33};

// Other config
#define SERIAL_BAUD 115200
#define SAMPLE_RATE 100 //Rate of updating potentiometer values
