pigatron-industries/xen_matrix/src/controllers/MatrixController.h

#ifndef FrequencyController_h
#define FrequencyController_h

#include "Controller.h"
#include "hardware/MixMatrix.h"
#include "MatrixDisplay.h"
#include <eurorack_dsp.h>

using namespace eurorack;

#define SAMPLERATE_DIVIDER 8
#define MATRIX_BANKS 16

class MatrixController : public ParameterizedController<2> {
    public:
        enum Parameter {
            BANK_SELECT = 0,
            MATRIX_MODE
        };

        MatrixController() : ParameterizedController() {}
        virtual void init(float sampleRate);
        virtual void init();
        virtual int cycleParameter(int amount);
        virtual void cycleValue(int amount);

        virtual void update();
        virtual void process();

    protected:

        LinearInput<AnalogInputPinT> ampCvInput = LinearInput<AnalogInputPinT>(Hardware::hw.cv1Input, -5, 5, 0, 5);
        LinearInput<AnalogInputPinT> waveCvInput = LinearInput<AnalogInputPinT>(Hardware::hw.cv2Input, -5, 5, 0, 5);

        MatrixDisplay display;

        struct SaveMatrixValues {
            uint8_t check = 0;
            MatrixValues matrixValues[MATRIX_BANKS];
        };
        ConfigField<SaveMatrixValues> banks;
        MixMatrix mixMatrix = MixMatrix(&banks.data.matrixValues[0]);

        void toggleMatrixValue(uint8_t x, uint8_t y);

        void save();
        void load();
};

#endif
