pigatron-industries/xen_matrix/(commit log)

2022-12-03 Added skeleton framework code
2022-12-03 Add hardware pin defs
2022-12-25 Code for matrix leds, pots and key matrix
2023-02-06 add offset to input and output voltages
    [xen_matrix_controls_6x6.brd, xen_teensy_motherboard_matrix_mki.brd, xen_teensy_motherboard_matrix_mki.sch]
2023-10-28 buffer calibration voltage
    [xen_teensy_motherboard_matrix_mki.brd, xen_teensy_motherboard_matrix_mki.sch]
